johannesbjaa/Snake_robot/README.md

# Snake_robot
Code for the snakebot in MMA4004
