johannesbjaa/Snake_robot/assembly1-4.17_TOP.stl

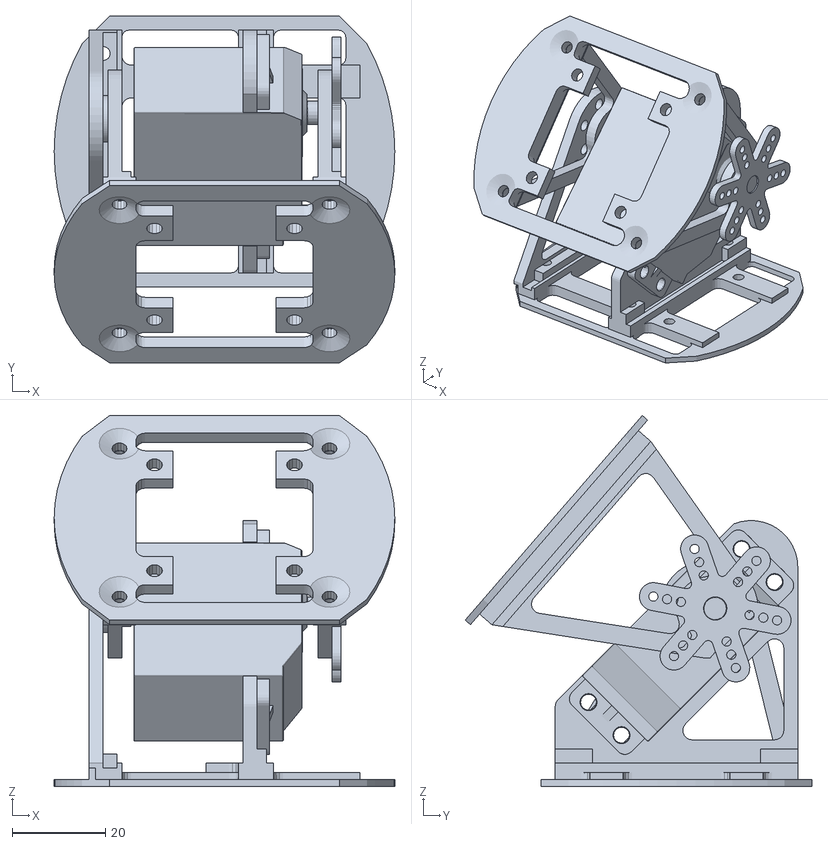
[picture p1: CAD file, 2026-10-05]
assembly1-4.17_TOP.stl
73.0 x 74.3 x 79.5
