johannesbjaa/Snake_robot/assembly-solidworks2012/dingmokuai-4.17.SLDASM

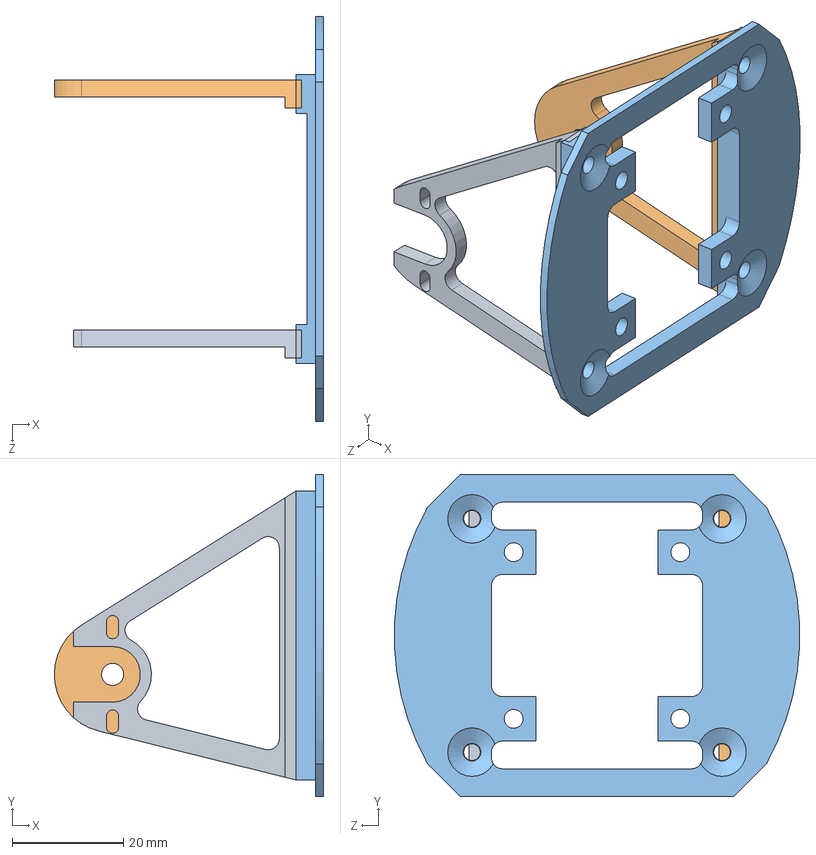
[picture p2: CAD file, 2026-10-05]
assembly-solidworks2012/dingmokuai-4.17.SLDASM
48.5 x 58.0 x 72.9 mm
shangdiban-4.17
dingceban1-4.17
dingceban2-4.17
