johannesbjaa/Snake_robot/assembly-solidworks2012/dimokuai-4.17.SLDASM

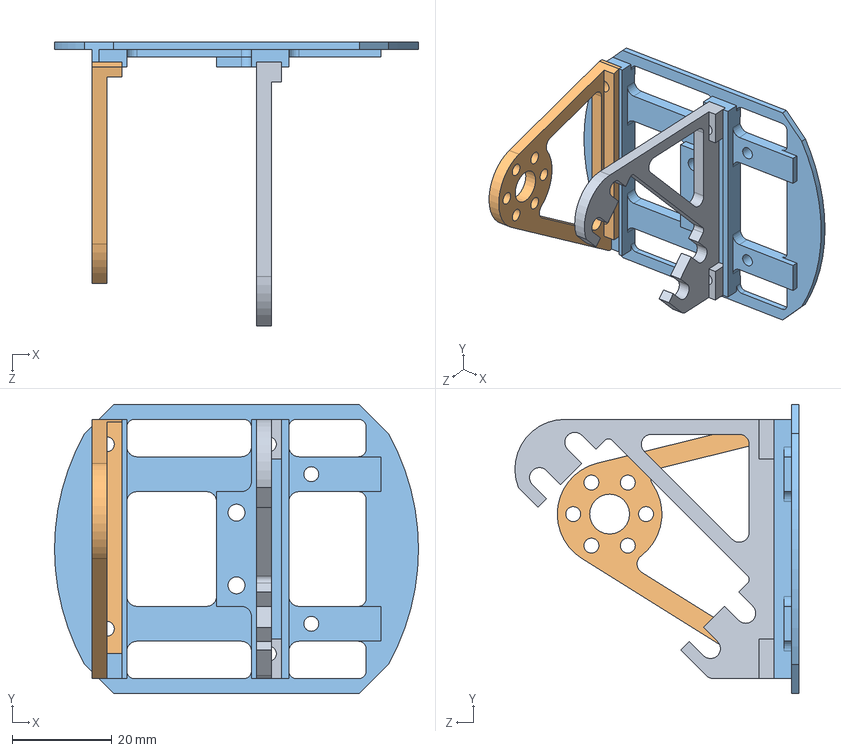
[picture p3: CAD file, 2026-10-05]
assembly-solidworks2012/dimokuai-4.17.SLDASM
73.0 x 58.0 x 57.0 mm
diban-4.17
diceban1-4.17
diceban2-4.17
