johannesbjaa/Snake_robot/assembly-solidworks2012/dingceban1-4.17.SLDPRT

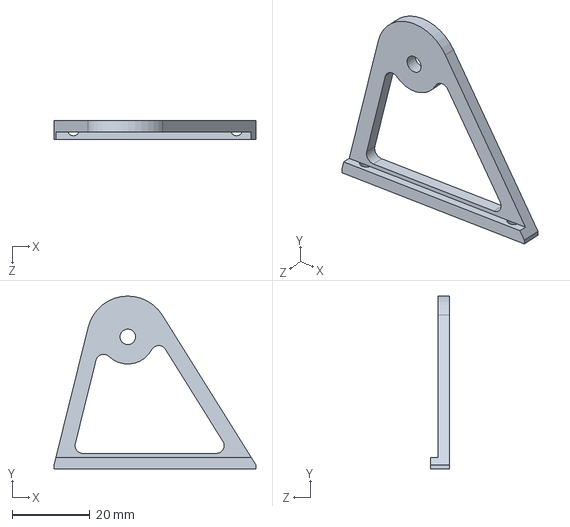
[picture p4: CAD file, 2026-10-05]
assembly-solidworks2012/dingceban1-4.17.SLDPRT
52.0 x 44.5 x 5.00 mm
