johannesbjaa/Snake_robot/meshes/bearing.stl

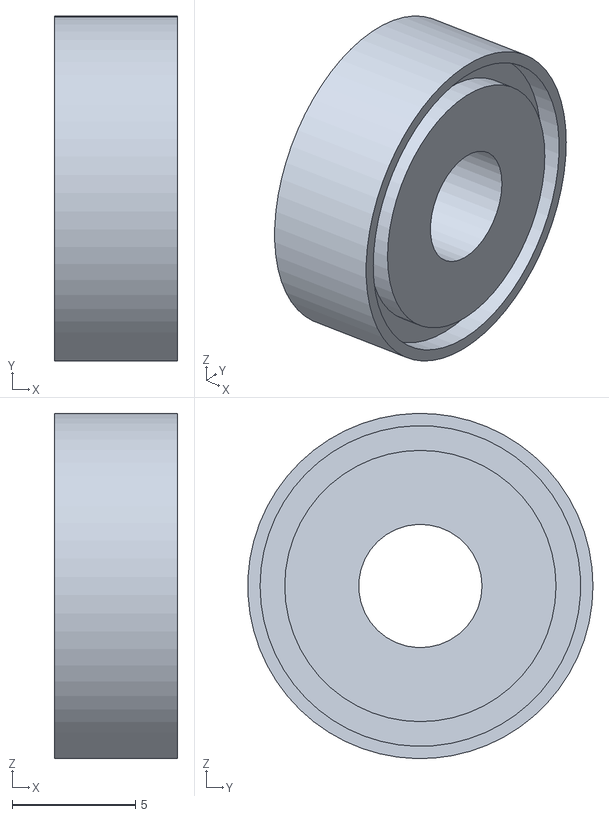
[picture p5: CAD file, 2026-10-05]
meshes/bearing.stl
5.00 x 14.0 x 14.0
