johannesbjaa/Snake_robot/Slange robot/Slange robot gcode/Modul_2_slange_robot_motor_klammer.3mf

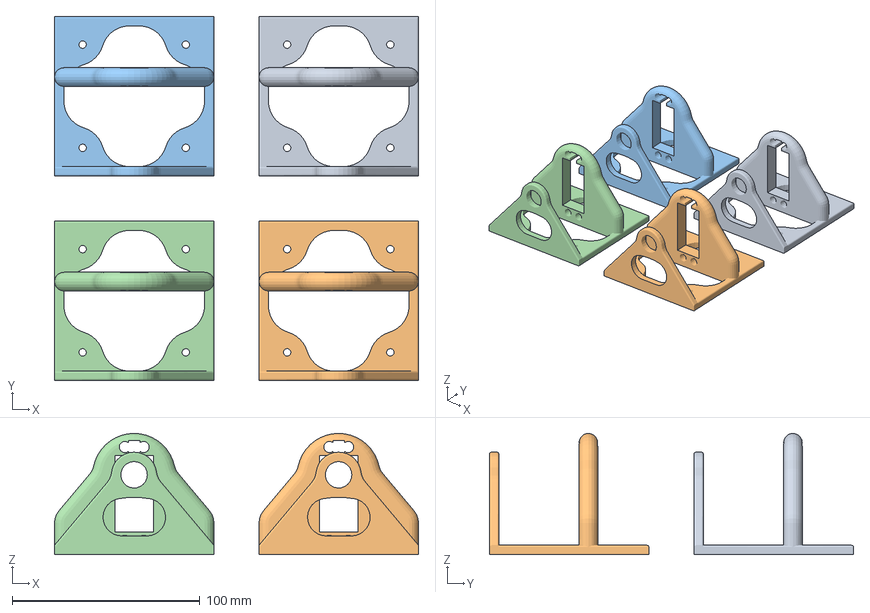
[picture p6: CAD file, 2026-10-05]
Slange robot/Slange robot gcode/Modul_2_slange_robot_motor_klammer.3mf
194.0 x 194.0 x 64.6 mm
Modul_2_slange_robot_motor_klammer.stl x 4
