johannesbjaa/Snake_robot/Slange robot/Slange robot stl/lagerpinn_mellom_moduler.stl

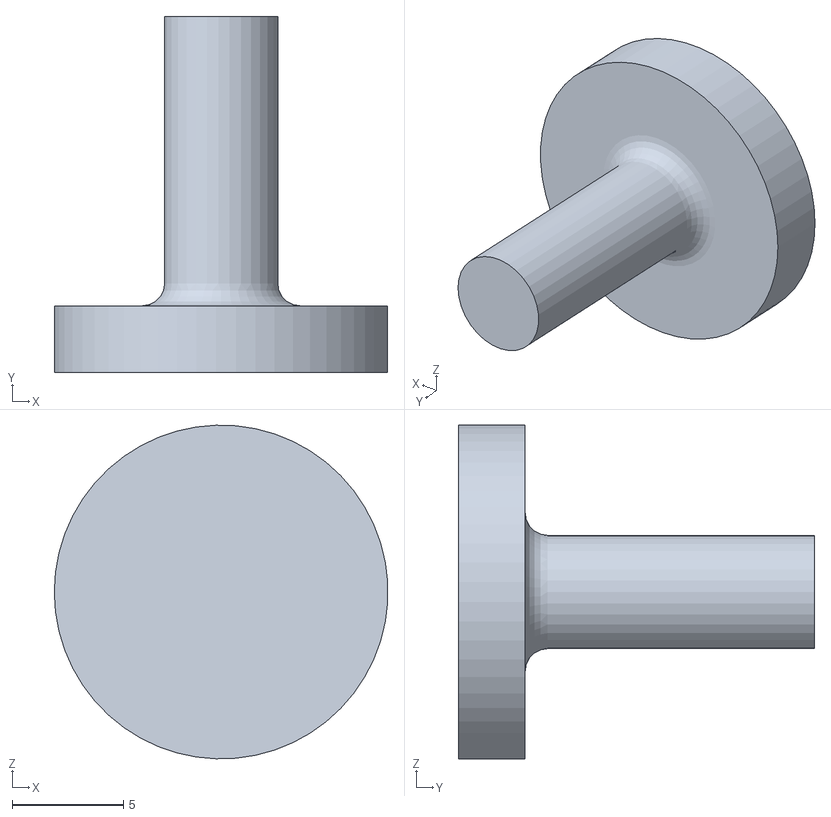
[picture p7: CAD file, 2026-10-05]
Slange robot/Slange robot stl/lagerpinn_mellom_moduler.stl
15.0 x 16.0 x 15.0
