johannesbjaa/Snake_robot/assembly-solidworks2012/diban-4.17.SLDPRT

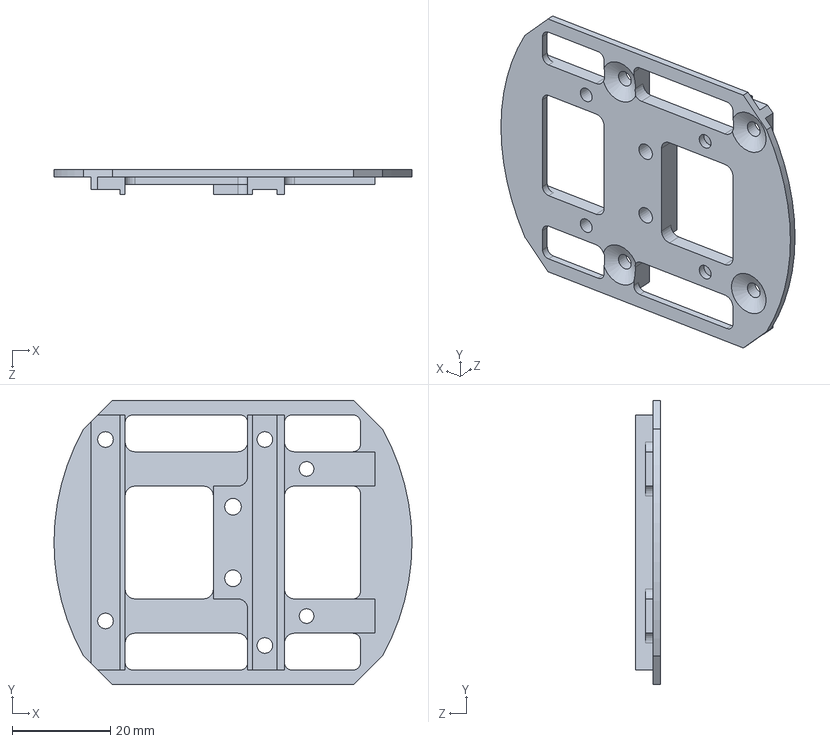
[picture p8: CAD file, 2026-10-05]
assembly-solidworks2012/diban-4.17.SLDPRT
73.0 x 58.0 x 5.00 mm
