johannesbjaa/Snake_robot/meshes/modul1.stl

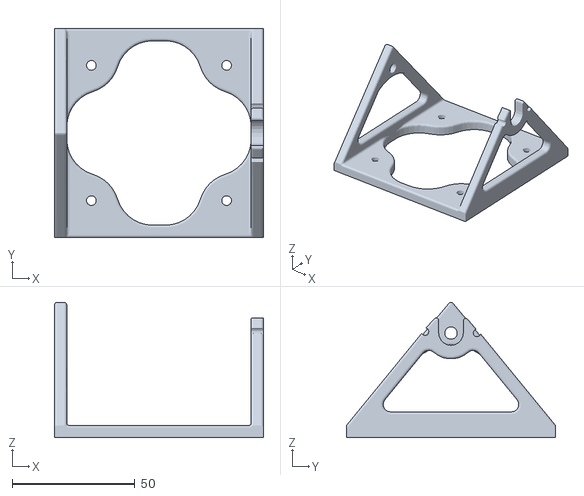
[picture p9: CAD file, 2026-10-05]
meshes/modul1.stl
85.0 x 85.0 x 55.1
