johannesbjaa/Snake_robot/servoplate-4.17.stl

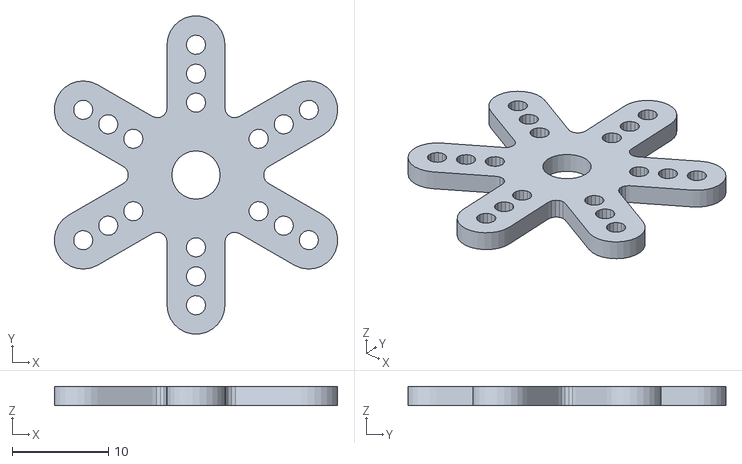
[picture p10: CAD file, 2026-10-05]
servoplate-4.17.stl
29.4 x 33.0 x 2.00
