johannesbjaa/Snake_robot/Slange robot/Slange robot stl/Nase_modul_IRsensorer.stl

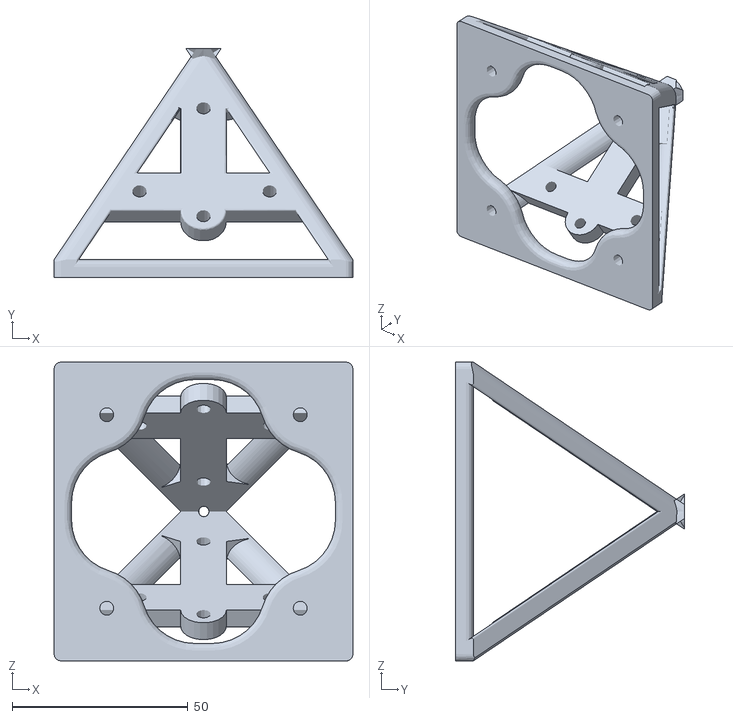
[picture p11: CAD file, 2026-10-05]
Slange robot/Slange robot stl/Nase_modul_IRsensorer.stl
85.0 x 65.0 x 85.0
