johannesbjaa/Snake_robot/assembly-solidworks2012/dingceban2-4.17.SLDPRT

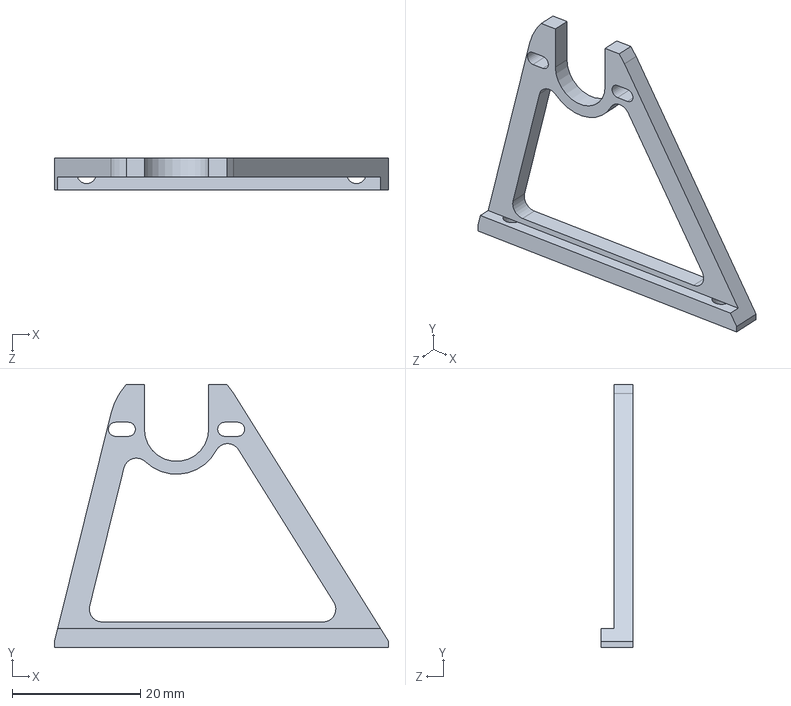
[picture p12: CAD file, 2026-10-05]
assembly-solidworks2012/dingceban2-4.17.SLDPRT
52.0 x 41.0 x 5.00 mm
