johannesbjaa/Snake_robot/meshes/servo.stl

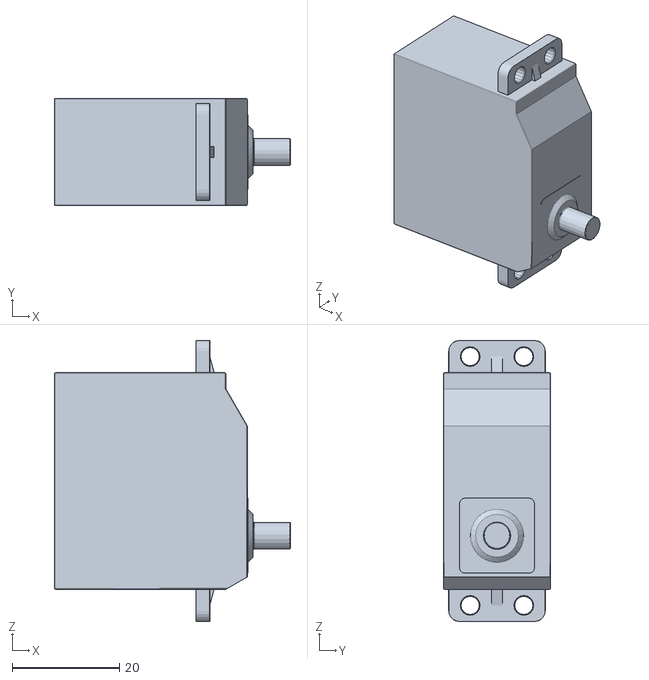
[picture p13: CAD file, 2026-10-05]
meshes/servo.stl
44.1 x 20.0 x 52.4
