johannesbjaa/Snake_robot/assembly-solidworks2012/zhoutao-4.17.SLDPRT

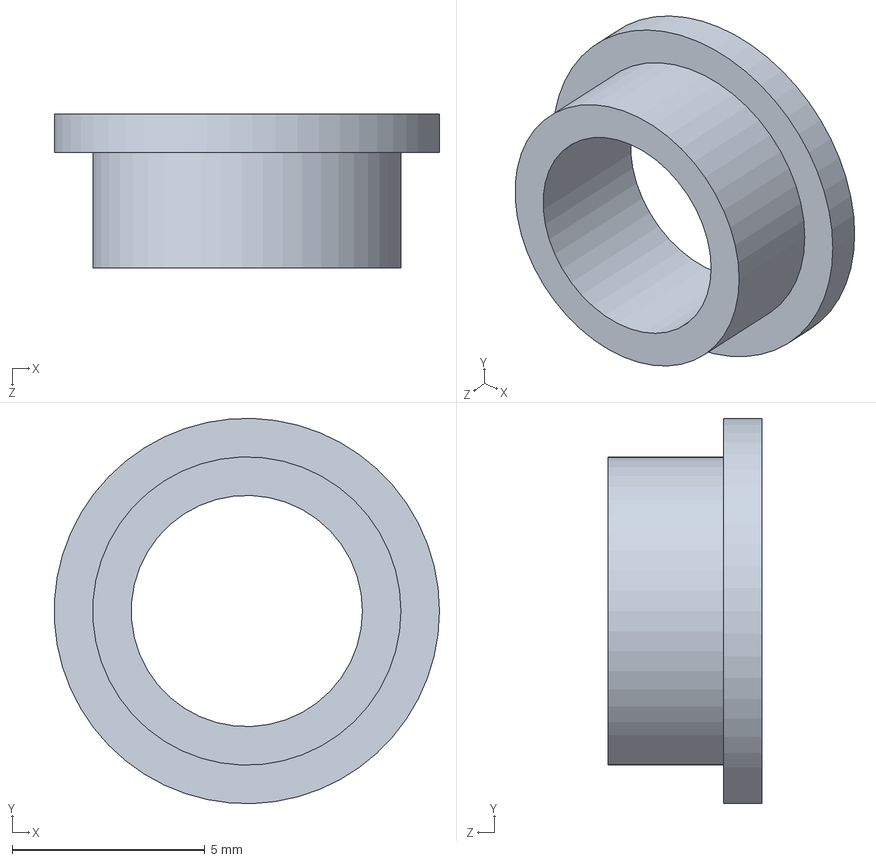
[picture p14: CAD file, 2026-10-05]
assembly-solidworks2012/zhoutao-4.17.SLDPRT
9.99 x 10.00 x 4.00 mm
