johannesbjaa/Snake_robot/meshes/modul2.stl

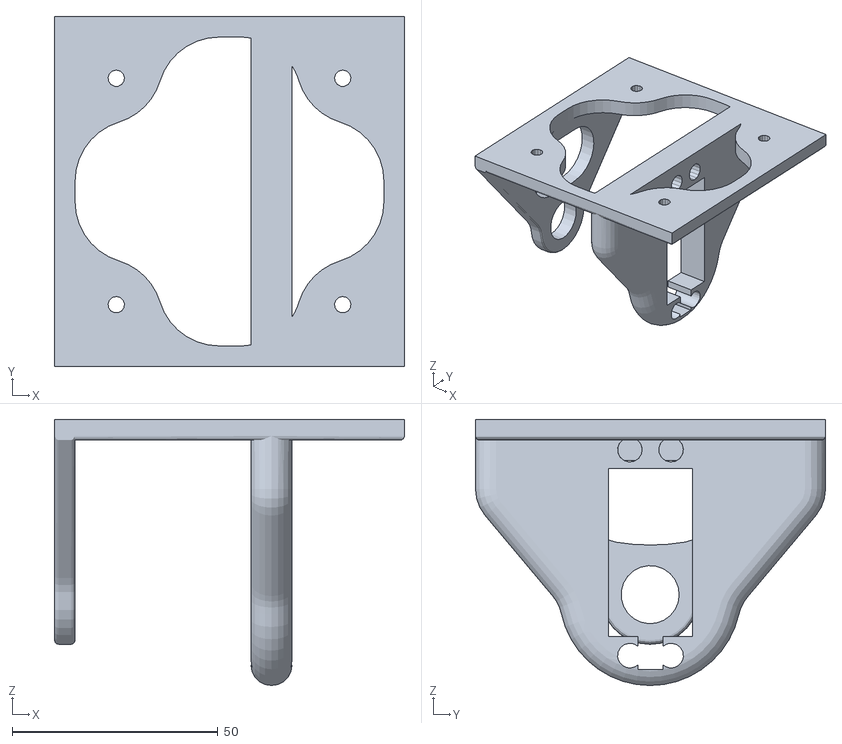
[picture p15: CAD file, 2026-10-05]
meshes/modul2.stl
85.0 x 85.0 x 64.6
