johannesbjaa/Snake_robot/Slange robot/Slange robot stl/Motor_Asembely_modul_1.stl

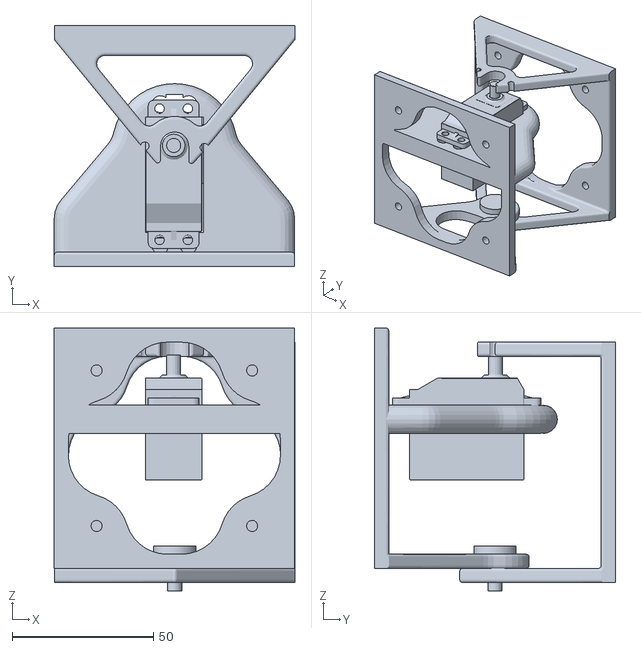
[picture p16: CAD file, 2026-10-05]
Slange robot/Slange robot stl/Motor_Asembely_modul_1.stl
85.1 x 85.1 x 93.0
