johannesbjaa/Snake_robot/assembly-solidworks2012/diceban2-4.17.SLDPRT

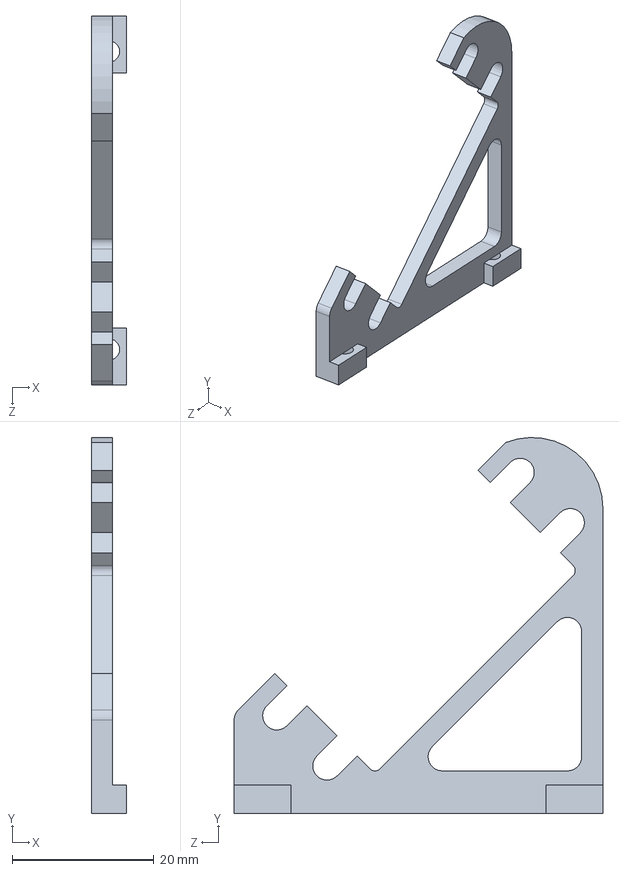
[picture p17: CAD file, 2026-10-05]
assembly-solidworks2012/diceban2-4.17.SLDPRT
5.00 x 53.0 x 52.0 mm
