johannesbjaa/Snake_robot/zhou-4.17.stl

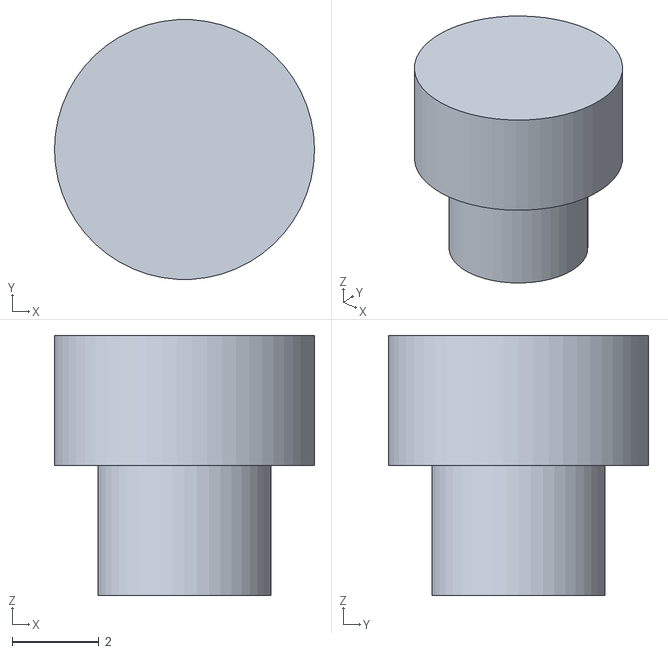
[picture p18: CAD file, 2026-10-05]
zhou-4.17.stl
6.00 x 5.99 x 6.00
