johannesbjaa/Snake_robot/assembly-solidworks2012/diceban1-4.17.SLDPRT

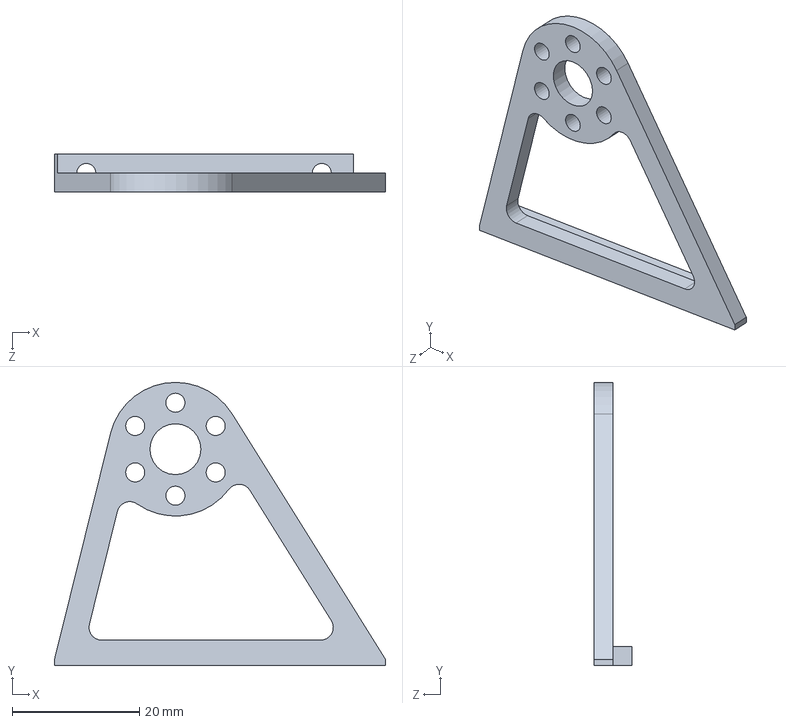
[picture p19: CAD file, 2026-10-05]
assembly-solidworks2012/diceban1-4.17.SLDPRT
52.0 x 44.5 x 6.00 mm
