johannesbjaa/Snake_robot/assembly-solidworks2012/shangdiban-4.17.SLDPRT

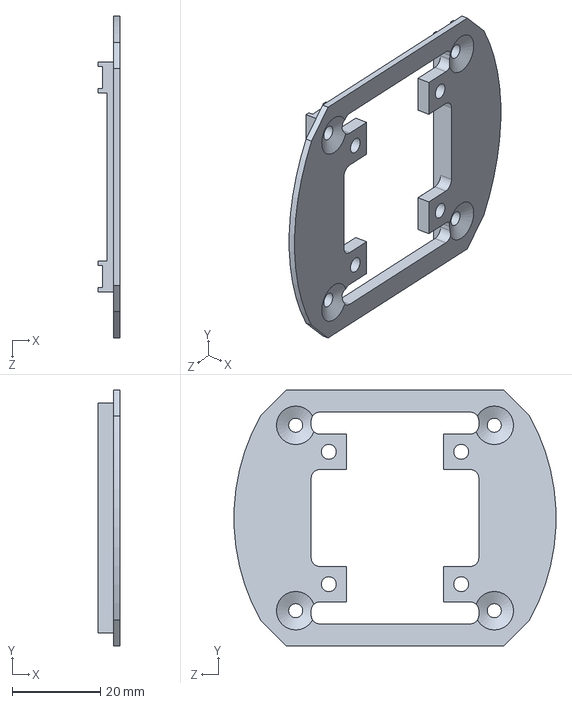
[picture p20: CAD file, 2026-10-05]
assembly-solidworks2012/shangdiban-4.17.SLDPRT
5.00 x 58.0 x 72.9 mm
