johannesbjaa/Snake_robot/(list of files, cad)

Other CAD files:
assembly-solidworks2012/assembly1-4.17.SLDASM
dimokuai-4.17.stl
Slange robot/Slange robot stl/Modul_1_slange_robot_motor_slott.stl
zhoutao-4.17.stl
meshes/pin.stl
Slange robot/Slange robot stl/forenklalager_14_5_5.stl
meshes/nose.stl
S3003-4.17.stl
Slange robot/Slange robot stl/Modul_2_slange_robot_motor_klammer.stl
dingmokuai-4.17.stl
assembly-solidworks2012/zhou-4.17.SLDPRT
assembly-solidworks2012/S3003-4.17.SLDPRT
assembly-solidworks2012/servoplate-4.17.SLDPRT
Slange robot/Slange robot/Modul_1_slange_robot_motor_slott.ipt
Slange robot/Slange robot/Modul_2_slange_robot_motor_klammer.ipt
Slange robot/Slange robot/Motor_Asembely_modul_1.iam
Slange robot/Slange robot/OldVersions/Modul_1_slange_robot_motor_slott.0001.ipt
Slange robot/Slange robot/OldVersions/Modul_2_slange_robot_motor_klammer.0002.ipt
Slange robot/Slange robot/OldVersions/Servo_motor_forenkla_1.0001.ipt
Slange robot/Slange robot/OldVersions/lagerpinn_mellom_moduler.0001.ipt
Slange robot/Slange robot/Servo motor.ipt
Slange robot/Slange robot/Servo_motor_forenkla_1.ipt
Slange robot/Slange robot/forenkla batteri.ipt
Slange robot/Slange robot/forenkla kamera M5.ipt
Slange robot/Slange robot/forenklalager_14_5_5.ipt
Slange robot/Slange robot/lagerpinn_mellom_moduler.ipt
