johannesbjaa/Snake_robot/snake_robot/bmi270_config.h

// BMI270 configuration blob.  The BMI270 needs it uploaded after every power up
// before it measures (see bmi270Begin in snake_robot.ino).  Copied unchanged from
// Bosch's BMI270 Sensor API v2.71.8 (bmi270.c), as shipped in the Arduino_BMI270_BMM150
// library.  Bosch's licence:
/**
* Copyright (c) 2021 Bosch Sensortec GmbH. All rights reserved.
*
* BSD-3-Clause
*
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
* 1. Redistributions of source code must retain the above copyright
*    notice, this list of conditions and the following disclaimer.
*
* 2. Redistributions in binary form must reproduce the above copyright
*    notice, this list of conditions and the following disclaimer in the
*    documentation and/or other materials provided with the distribution.
*
* 3. Neither the name of the copyright holder nor the names of its
*    contributors may be used to endorse or promote products derived from
*    this software without specific prior written permission.
*
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
* @file       bmi270.c
* @date       2021-09-30
* @version    v2.71.8
*
*/

#pragma once
#include <stdint.h>

const uint8_t BMI270_CONFIG[8192] = {
  0xc8, 0x2e, 0x00, 0x2e, 0x80, 0x2e, 0x3d, 0xb1, 0xc8, 0x2e, 0x00, 0x2e, 0x80, 0x2e, 0x91, 0x03,
  0x80, 0x2e, 0xbc, 0xb0, 0x80, 0x2e, 0xa3, 0x03, 0xc8, 0x2e, 0x00, 0x2e, 0x80, 0x2e, 0x00, 0xb0,
  0x50, 0x30, 0x21, 0x2e, 0x59, 0xf5, 0x10, 0x30, 0x21, 0x2e, 0x6a, 0xf5, 0x80, 0x2e, 0x3b, 0x03,
  0x00, 0x00, 0x00, 0x00, 0x08, 0x19, 0x01, 0x00, 0x22, 0x00, 0x75, 0x00, 0x00, 0x10, 0x00, 0x10,
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
  0x88, 0x01, 0x8a, 0x01, 0x8c, 0x01, 0x8f, 0x01, 0x8d, 0x01, 0x92, 0x01, 0x91, 0x01, 0xdd, 0x00,
  0x9f, 0x01, 0x7e, 0x01, 0xdb, 0x00, 0xb6, 0x01, 0x70, 0x69, 0x26, 0xd3, 0x9c, 0x07, 0x1f, 0x05,
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
};
